hotchk155/QuadVCA/docs/header pins.docx

CONTROL BOARD

SNK3 | SRC2 (7SEG) | SNK1 | SNK4 | SNK6 | SRC4 (LEDS) | MIDI_IN_T Pin 4
SRC3 (7SEG) | SNK2 | SRC1 (7SEG) | SNK5 | SNK8 | SNK7 | MIDI_IN_R Pin 5

SW_READ Read line for multiplexed switches needs pull up | IND4 Channel D VCA status LED active low | CVIN3 Socket normalled to ground | CVIN2 Socket normalled to ground | SWITCH Active low needs pull up | CKIN Socket normalled to ground | DGND
DGND | CVIN4 Socket normalled to ground | IND3 Channel C VCA status LED active low | IND2 Channel B VCA status LED active low | IND1 Channel A VCA status LED active low | CVIN1 Socket normalled to ground | +5V

SIG_IN3 Channel C input socket tip Normalled to channel B input tip | SIG_OUT4 Channel D output tip | SIG_IN2 Channel B input socket tip Normalled to channel A input tip | AGND | ATT_IN4 C/W (top) end of track of attenuator pot D
SIG_IN4 Channel D input socket tip. Normalled to channel C input tip | SIG_OUT3 Channel C output tip | ATT_OUT2 Wiper of attenuator pot B | ATT_IN2 C/W (top) end of track of attenuator pot B | ATT_OUT4 Wiper of attenuator pot D

ATT_OUT1 Wiper of attenuator pot A | SIG_OUT1 Channel A output tip | SIG_OUT2 Channel B output tip | ATT_IN3 C/W (top) end of track of attenuator pot C | ATT_OUT3 Wiper of attenuator pot C
ATT_IN1 C/W (top) end of track of attenuator pot A | SIG_IN1 Channel A input socket tip. | AGND | AGND | AGND

BASE BOARD

SINK Shift reg pin via resistor | SRC transistor | SINK Shift reg pin via resistor | SINK Shift reg pin via resistor | SINK Shift reg pin via resistor | SRC transistor | MIDI Pin 4
SRC transistor | SINK Shift reg pin via resistor | SRC transistor | SINK Shift reg pin via resistor | SINK Shift reg pin via resistor | SINK Shift reg pin via resistor | MIDI Pin 5

KB_READ | IND4 To op-amp sink | CV Analog input | CV Analog input | SWITCH Input line | CKIN Analog input | DGND
DGND | CV Analog input | IND3 To op-amp sink | IND2 To op-amp sink | IND1 To op-amp sink | CV Analog input | +5V

Check indicator PWM vs VCA PWM vs sockets

A D

B C

SIGIN3 To VCA input C | SIGOUT4 | SIGIN2 | AGND | TO_ATT4
SIGIN4 | SIGOUT3 | FR_ATT2 | TO_ATT2 | FR_ATT4

FR_ATT1 | SIGOUT1 | SIGOUT2 | TO_ATT3 | FR_ATT3
TO_ATT1 | SIGIN1 | +12V | AGND | -12V
