hotchk155/QuadVCA/main_board/main_board.brd

## EAGLE design main_board/main_board.brd (2017-09-06)

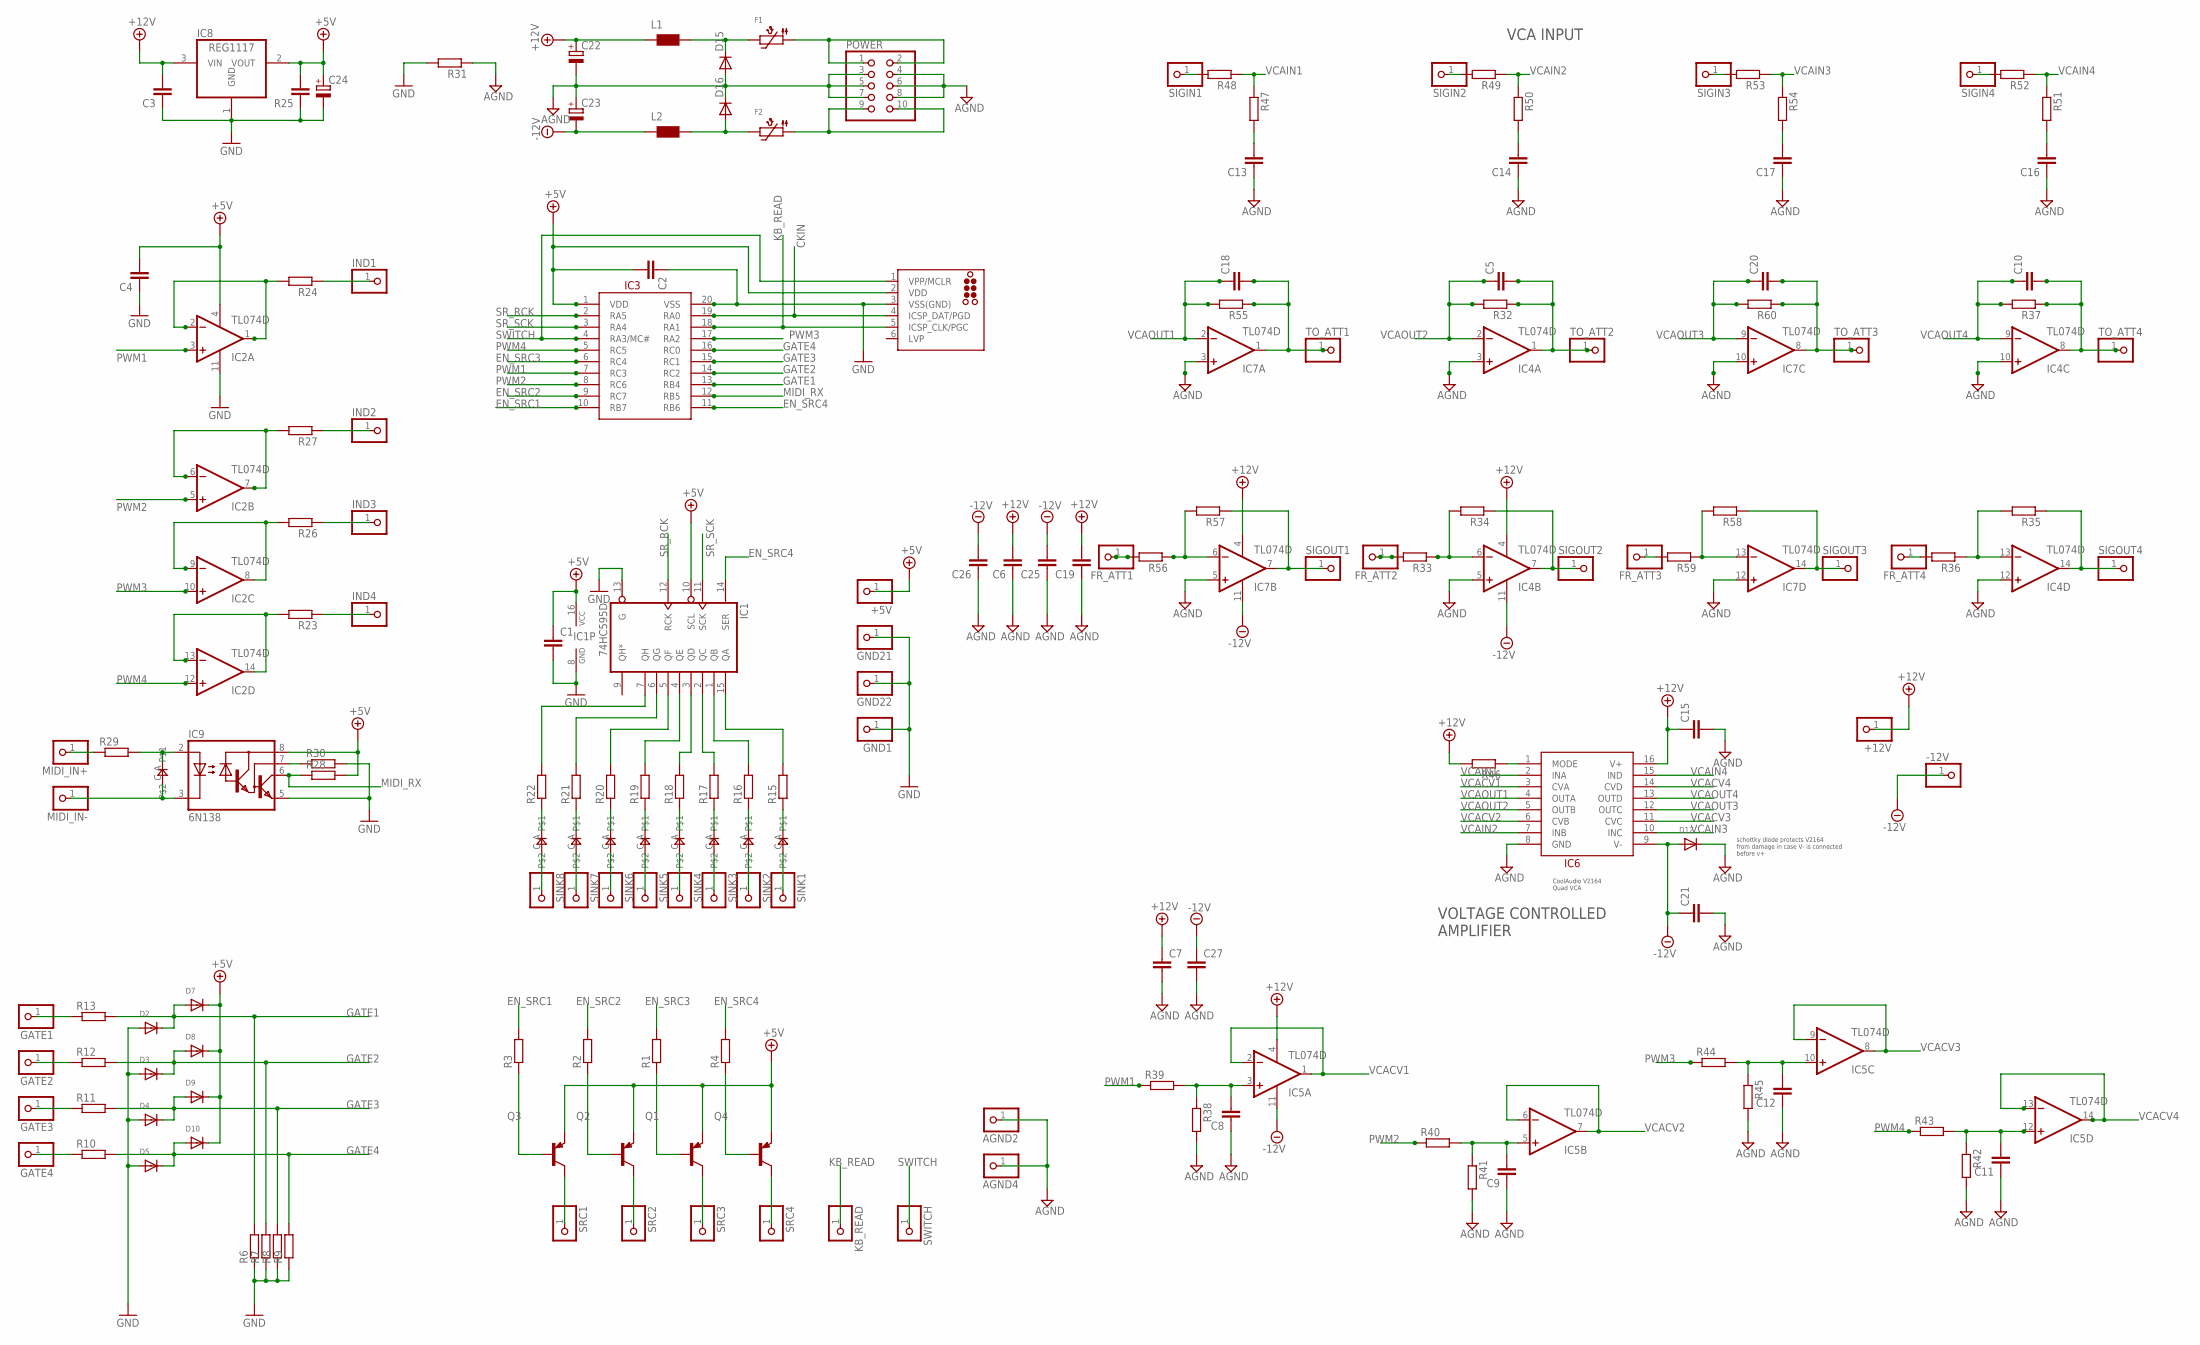
[picture p1: schematic main_board.sch]

Parts:
+5V, +12V: PINHD-1X1; 1X01
-12V: PINHD-1X1; 1X01
AGND2, AGND4: PINHD-1X1; 1X01
C1, C2, C3, C4, C5, C6, C7, C8, C9, C10, C11, C12, C13, C14, C15, C16, C17, C18, C19, C20, C21, C25, C26, C27: C-EUC0805; C0805
C22, C23: CPOL-EUE2.5-7; E2,5-7
C24: CPOL-EUE2.5-5; E2,5-5
D2, D3, D4, D5, D7, D8, D9, D10, D12: DIODESOD-123; SOD-123
D11, D13, D14, D17, D18, D19, D20, D21, D22: 0805DIODE
D15, D16: MBR0520LT; SOD123
F1, F2: PTC1210
FR_ATT1, FR_ATT2, FR_ATT3, FR_ATT4: PINHD-1X1; 1X01
GATE1, GATE2, GATE3, GATE4: PINHD-1X1; 1X01
GND1, GND21, GND22: PINHD-1X1; 1X01
IC1: 74HC595D; SO16
IC2, IC4, IC5, IC7: TL074D; SO14
IC3: PIC16F1829SOIC; SO20W
IC6: V2164; SO16
IC8: REG1117; SOT223
IC9: 6N138; DIL08
ICSP: TC2030-MCP-NL
IND1, IND2, IND3, IND4: PINHD-1X1; 1X01
KB_READ: PINHD-1X1; 1X01
L1, L2: WE-CBF_0805; 0805
MIDI_IN+: PINHD-1X1; 1X01
MIDI_IN-: PINHD-1X1; 1X01
POWER: PINHD-2X5; 2X05
Q1, Q2, Q3, Q4: MMBT3906LT1-PNP-SOT23-BEC; SOT23-BEC
R1, R2, R3, R4, R6, R7, R8, R9, R10, R11, R12, R13, R15, R16, R17, R18, R19, R20, R21, R22, R23, R24, R26, R27, R28, R29, R30, R31, R32, R33, R34, R35, R36, R37, R38, R39, R40, R41, R42, R43, R44, R45, R46, R47, R48, R49, R50, R51, R52, R53, R54, R55, R56, R57, R58, R59, R60: R-EU_R0805; R0805
R25: C-EUC0805; C0805
SIGIN1, SIGIN2, SIGIN3, SIGIN4: PINHD-1X1; 1X01
SIGOUT1, SIGOUT2, SIGOUT3, SIGOUT4: PINHD-1X1; 1X01
SINK1, SINK2, SINK3, SINK4, SINK5, SINK6, SINK7, SINK8: PINHD-1X1; 1X01
SRC1, SRC2, SRC3, SRC4: PINHD-1X1; 1X01
SWITCH: PINHD-1X1; 1X01
TO_ATT1, TO_ATT2, TO_ATT3, TO_ATT4: PINHD-1X1; 1X01

Connections:
+5V: +5V.1, C1.1, C2.2, C4.2, C24.+, D7.C, D8.C, D9.C, D10.C, IC1.10 (SCL), IC1.16 (VCC), IC2.4 (V+), IC3.1 (VDD), IC8.2 (VOUT), IC9.8 (VCC), ICSP.2 (VDD), Q1.E, Q2.E, Q3.E, Q4.E, R25.2, R28.2
+12V: +12V.1, C3.2, C6.2, C7.1, C15.1, C19.2, C22.+, IC4.4 (V+), IC5.4 (V+), IC6.16 (V+), IC7.4 (V+), IC8.3 (VIN), L1.1, R46.2
-12V: -12V.1, C21.1, C23.-, C25.2, C26.2, C27.1, D12.A, IC4.11 (V-), IC5.11 (V-), IC6.9 (V-), IC7.11 (V-), L2.1
AGND: AGND2.1, AGND4.1, C6.1, C7.2, C8.1, C9.1, C11.1, C12.1, C13.1, C14.1, C15.2, C16.1, C17.1, C19.1, C21.2, C22.-, C23.+, C25.1, C26.1, C27.2, D12.C, D15.A, D16.C, IC4.3 (+IN), IC4.5 (+IN), IC4.10 (+IN), IC4.12 (+IN), IC6.8 (GND), IC7.3 (+IN), IC7.5 (+IN), IC7.10 (+IN), IC7.12 (+IN), POWER.3, POWER.4, POWER.5, POWER.6, POWER.7, POWER.8, R31.1, R38.2, R41.2, R42.2, R45.2
CKIN: IC3.19 (RA0), ICSP.4 (ICSP_DAT/PGD)
EN_SRC1: IC3.10 (RB7), R3.2
EN_SRC2: IC3.9 (RC7), R2.2
EN_SRC3: IC3.6 (RC4), R1.2
EN_SRC4: IC1.14 (SER), IC3.11 (RB6), R4.2
FR_ATT1: FR_ATT1.1, R56.2
GATE1: D2.C, D7.A, IC3.13 (RB4), R6.2, R13.2
GATE2: D3.C, D8.A, IC3.14 (RC2), R7.2, R12.2
GATE3: D4.C, D9.A, IC3.15 (RC1), R8.2, R11.2
GATE4: D5.C, D10.A, IC3.16 (RC0), R9.2, R10.2
GND: C1.2, C2.1, C3.1, C4.1, C24.-, D2.A, D3.A, D4.A, D5.A, GND1.1, GND21.1, GND22.1, IC1.8 (GND), IC1.13 (G), IC2.11 (V-), IC3.20 (VSS), IC8.1 (GND), IC9.5 (GND), ICSP.3 (VSS(GND)), R6.1, R7.1, R8.1, R9.1, R25.1, R30.2, R31.2
KB_READ: IC3.18 (RA1), ICSP.5 (ICSP_CLK/PGC), KB_READ.1
MIDI_RX: IC3.12 (RB5), IC9.6 (VO), R28.1
unnamed: IC1.7 (QH), R22.2
unnamed: IC1.6 (QG), R21.2
unnamed: IC1.5 (QF), R20.2
unnamed: IC1.4 (QE), R19.2
unnamed: IC1.3 (QD), R18.2
unnamed: IC1.2 (QC), R17.2
unnamed: IC1.1 (QB), R16.2
unnamed: IC1.15 (QA), R15.2
unnamed: D13.A, R22.1
unnamed: D14.A, R21.1
unnamed: D17.A, R20.1
unnamed: D18.A, R19.1
unnamed: D19.A, R18.1
unnamed: D20.A, R17.1
unnamed: D21.A, R16.1
unnamed: D22.A, R15.1
unnamed: Q3.C, SRC1.1
unnamed: Q2.C, SRC2.1
unnamed: Q1.C, SRC3.1
unnamed: Q4.C, SRC4.1
unnamed: IC6.1 (MODE), R46.1
unnamed: Q3.B, R3.1
unnamed: Q2.B, R2.1
unnamed: Q1.B, R1.1
unnamed: Q4.B, R4.1
unnamed: D13.C, SINK8.1
unnamed: IC7.6 (-IN), R56.1, R57.2
unnamed: IC7.7 (OUT), R57.1, SIGOUT1.1
unnamed: D14.C, SINK7.1
unnamed: IC7.13 (-IN), R58.2, R59.1
unnamed: IC7.14 (OUT), R58.1, SIGOUT3.1
unnamed: D15.C, F1.P$2 (2), L1.2
unnamed: IC4.6 (-IN), R33.1, R34.2
unnamed: IC4.7 (OUT), R34.1, SIGOUT2.1
unnamed: D16.A, F2.P$2 (2), L2.2
unnamed: IC4.13 (-IN), R35.2, R36.1
unnamed: IC4.14 (OUT), R35.1, SIGOUT4.1
unnamed: C13.2, R47.2
unnamed: R48.2, SIGIN1.1
unnamed: C14.2, R50.2
unnamed: R49.2, SIGIN2.1
unnamed: C17.2, R54.2
unnamed: R53.2, SIGIN3.1
unnamed: C16.2, R51.2
unnamed: R52.2, SIGIN4.1
unnamed: IND1.1, R24.1
unnamed: IC2.1 (OUT), IC2.2 (-IN), R24.2
unnamed: C8.2, IC5.3 (+IN), R38.1, R39.2
unnamed: D17.C, SINK6.1
unnamed: IC2.6 (-IN), IC2.7 (OUT), R27.2
unnamed: IND2.1, R27.1
unnamed: C9.2, IC5.5 (+IN), R40.2, R41.1
unnamed: IC2.8 (OUT), IC2.9 (-IN), R26.2
unnamed: IND3.1, R26.1
unnamed: C12.2, IC5.10 (+IN), R44.2, R45.1
unnamed: IC2.13 (-IN), IC2.14 (OUT), R23.2
unnamed: IND4.1, R23.1
unnamed: C11.2, IC5.12 (+IN), R42.1, R43.2
unnamed: D18.C, SINK5.1
unnamed: FR_ATT2.1, R33.2
unnamed: GATE1.1, R13.1
unnamed: IC9.7 (VB), R30.1
unnamed: F2.P$1 (1), POWER.9, POWER.10
unnamed: D11.A, IC9.2 (A), R29.2
unnamed: D11.C, IC9.3 (C), MIDI_IN-.1
unnamed: MIDI_IN+.1, R29.1
unnamed: GATE2.1, R12.1
unnamed: GATE3.1, R11.1
unnamed: GATE4.1, R10.1
unnamed: FR_ATT3.1, R59.2
unnamed: FR_ATT4.1, R36.2
unnamed: D19.C, SINK4.1
unnamed: D20.C, SINK3.1
unnamed: F1.P$1 (1), POWER.1, POWER.2
unnamed: D21.C, SINK2.1
unnamed: D22.C, SINK1.1
PWM1: IC2.3 (+IN), IC3.7 (RC3), R39.1
PWM2: IC2.5 (+IN), IC3.8 (RC6), R40.1
PWM3: IC2.10 (+IN), IC3.17 (RA2), R44.1
PWM4: IC2.12 (+IN), IC3.5 (RC5), R43.1
SR_RCK: IC1.12 (RCK), IC3.2 (RA5)
SR_SCK: IC1.11 (SCK), IC3.3 (RA4)
SWITCH: IC3.4 (RA3/MC#), ICSP.1 (VPP/MCLR), SWITCH.1
TO_ATT1: C18.2, IC7.1 (OUT), R55.1, TO_ATT1.1
TO_ATT2: C5.2, IC4.1 (OUT), R32.1, TO_ATT2.1
TO_ATT3: C20.2, IC7.8 (OUT), R60.1, TO_ATT3.1
TO_ATT4: C10.2, IC4.8 (OUT), R37.1, TO_ATT4.1
VCACV1: IC5.1 (OUT), IC5.2 (-IN), IC6.3 (CVA)
VCACV2: IC5.6 (-IN), IC5.7 (OUT), IC6.6 (CVB)
VCACV3: IC5.8 (OUT), IC5.9 (-IN), IC6.11 (CVC)
VCACV4: IC5.13 (-IN), IC5.14 (OUT), IC6.14 (CVD)
VCAIN1: IC6.2 (INA), R47.1, R48.1
VCAIN2: IC6.7 (INB), R49.1, R50.1
VCAIN3: IC6.10 (INC), R53.1, R54.1
VCAIN4: IC6.15 (IND), R51.1, R52.1
VCAOUT1: C18.1, IC6.4 (OUTA), IC7.2 (-IN), R55.2
VCAOUT2: C5.1, IC4.2 (-IN), IC6.5 (OUTB), R32.2
VCAOUT3: C20.1, IC6.12 (OUTC), IC7.9 (-IN), R60.2
VCAOUT4: C10.1, IC4.9 (-IN), IC6.13 (OUTD), R37.2

Notes on the sheet:
schottky diode protects V2164 from damage in case V- is connected before v+
CoolAudio V2164 Quad VCA
VCA INPUT
VOLTAGE CONTROLLED AMPLIFIER

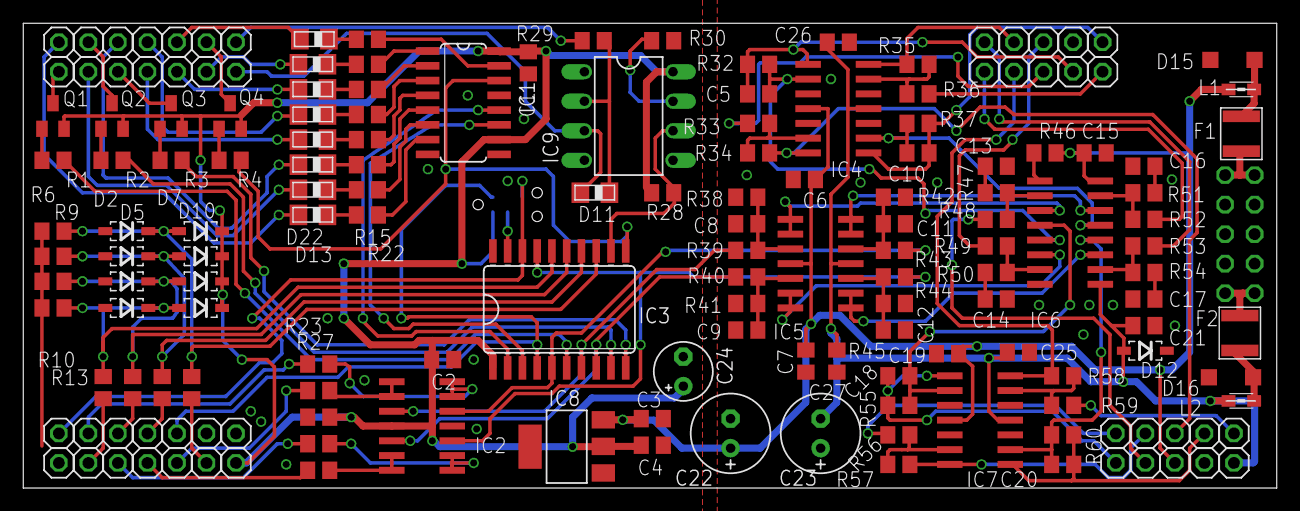
[picture p2: board main_board.brd from above]

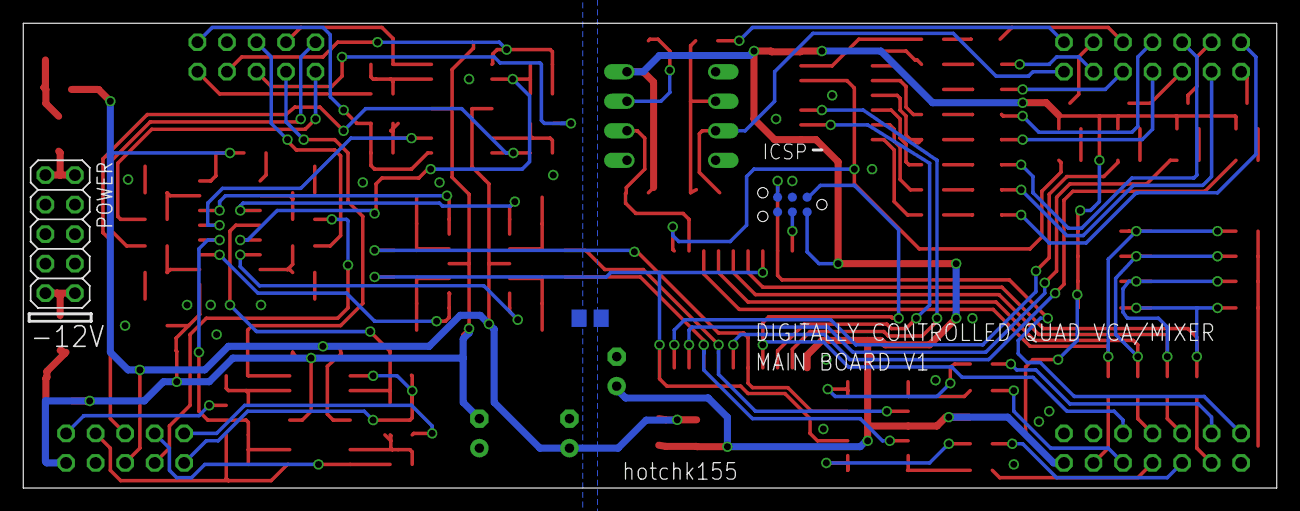
[picture p3: board main_board.brd from below]

Board: 2 copper layers, 107.8 x 40.0 mm, 172 parts (3 on the bottom side), 116 nets.
