hotchk155/QuadVCA/control_board/control_board.brd

## EAGLE design control_board/control_board.brd (2017-09-06)

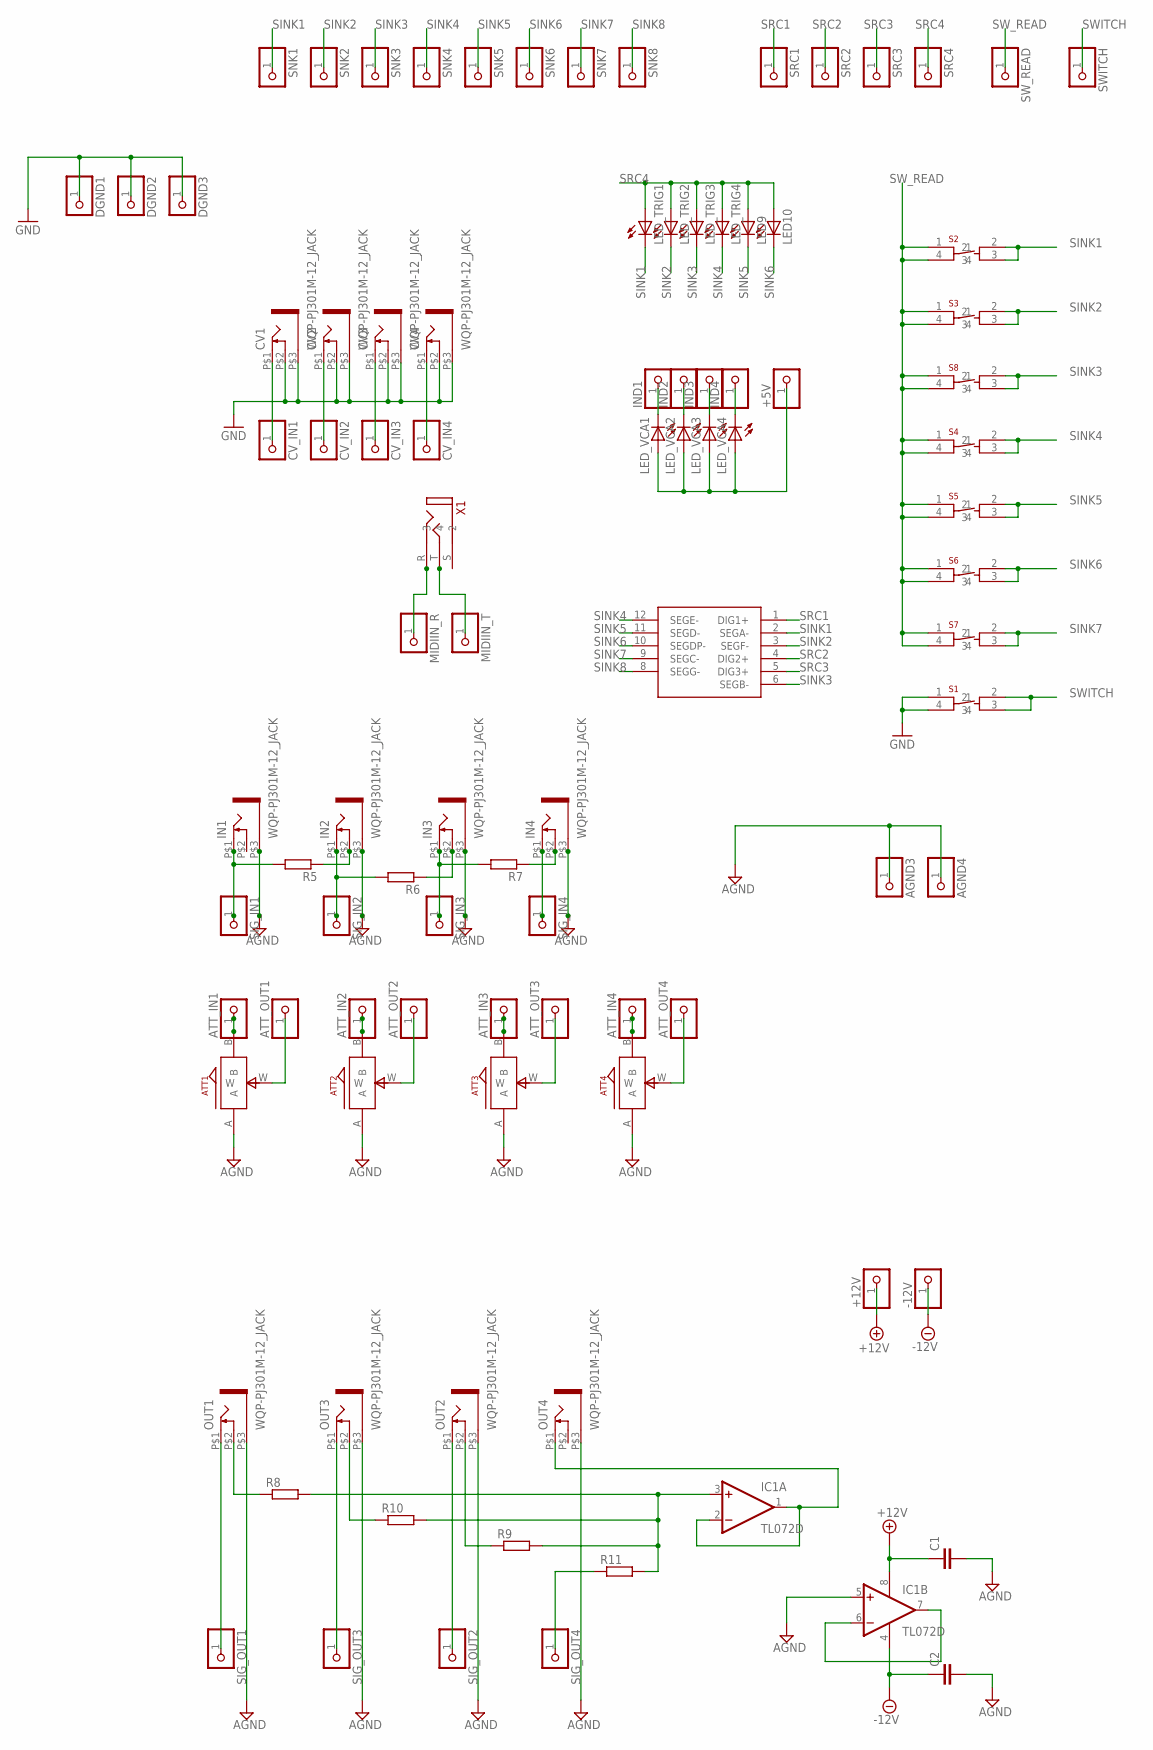
[picture p4: schematic control_board.sch]

Parts:
+5V, +12V: PINHD-1X1; 1X01
-12V: PINHD-1X1; 1X01
AGND3, AGND4: PINHD-1X1; 1X01
ATT1, ATT2, ATT3, ATT4: ALPS_POT_SMALL; SMALL_ALPS_POT
ATT_IN1, ATT_IN2, ATT_IN3, ATT_IN4: PINHD-1X1; 1X01
ATT_OUT1, ATT_OUT2, ATT_OUT3, ATT_OUT4: PINHD-1X1; 1X01
C1, C2: C-EUC0805; C0805
CV1, CV2, CV3, CV4: WQP-PJ301M-12_JACK
CV_IN1, CV_IN2, CV_IN3, CV_IN4: PINHD-1X1; 1X01
DGND1, DGND2, DGND3: PINHD-1X1; 1X01
DISP1: KYX2381_TRIPLE7SEG
IC1: TL072D; SO08
IN1, IN2, IN3, IN4: WQP-PJ301M-12_JACK
IND1, IND2, IND3, IND4: PINHD-1X1; 1X01
LED9, LED10: LED3MM
LED_TRIG1, LED_TRIG2, LED_TRIG3, LED_TRIG4: LED3MM
LED_VCA1, LED_VCA2, LED_VCA3, LED_VCA4: LED3MM
MIDIIN_R: PINHD-1X1; 1X01
MIDIIN_T: PINHD-1X1; 1X01
OUT1, OUT2, OUT3, OUT4: WQP-PJ301M-12_JACK
R5, R6, R7, R8, R9, R10, R11: R-EU_R0805; R0805
S1, S2, S3, S4, S5, S6, S7, S8: 6MM_TACT; 6MMTACT
SIG_IN1, SIG_IN2, SIG_IN3, SIG_IN4: PINHD-1X1; 1X01
SIG_OUT1, SIG_OUT2, SIG_OUT3, SIG_OUT4: PINHD-1X1; 1X01
SNK1, SNK2, SNK3, SNK4, SNK5, SNK6, SNK7, SNK8: PINHD-1X1; 1X01
SRC1, SRC2, SRC3, SRC4: PINHD-1X1; 1X01
SWITCH: PINHD-1X1; 1X01
SW_READ: PINHD-1X1; 1X01
X1: VERTICAL_3_5MM_SOCKETTHONK; PJ301CM

Connections:
+5V: +5V.1, LED_VCA1.A, LED_VCA2.A, LED_VCA3.A, LED_VCA4.A
+12V: +12V.1, C1.1, IC1.8 (V+)
-12V: -12V.1, C2.1, IC1.4 (V-)
AGND: AGND3.1, AGND4.1, ATT1.A, ATT2.A, ATT3.A, ATT4.A, C1.2, C2.2, IC1.5 (+IN), IN1.P$3 (1), IN2.P$3 (1), IN3.P$3 (1), IN4.P$3 (1), OUT1.P$3 (1), OUT2.P$3 (1), OUT3.P$3 (1), OUT4.P$3 (1)
GND: CV1.P$2 (3), CV1.P$3 (1), CV2.P$2 (3), CV2.P$3 (1), CV3.P$2 (3), CV3.P$3 (1), CV4.P$2 (3), CV4.P$3 (1), DGND1.1, DGND2.1, DGND3.1, S1.1, S1.4
unnamed: ATT1.W, ATT_OUT1.1
unnamed: ATT1.B, ATT_IN1.1
unnamed: ATT3.W, ATT_OUT3.1
unnamed: ATT2.B, ATT_IN2.1
unnamed: ATT2.W, ATT_OUT2.1
unnamed: ATT3.B, ATT_IN3.1
unnamed: ATT4.W, ATT_OUT4.1
unnamed: ATT4.B, ATT_IN4.1
unnamed: OUT1.P$2 (3), R8.1
unnamed: IN2.P$1 (2), R6.2, SIG_IN2.1
unnamed: IN3.P$1 (2), R7.2, SIG_IN3.1
unnamed: IN4.P$1 (2), SIG_IN4.1
unnamed: CV1.P$1 (2), CV_IN1.1
unnamed: CV2.P$1 (2), CV_IN2.1
unnamed: CV3.P$1 (2), CV_IN3.1
unnamed: CV4.P$1 (2), CV_IN4.1
unnamed: OUT1.P$1 (2), SIG_OUT1.1
unnamed: MIDIIN_R.1, X1.R (3)
unnamed: MIDIIN_T.1, X1.T (4)
unnamed: IND1.1, LED_VCA1.K (C)
unnamed: IND2.1, LED_VCA2.K (C)
unnamed: IND3.1, LED_VCA3.K (C)
unnamed: IND4.1, LED_VCA4.K (C)
unnamed: OUT3.P$1 (2), SIG_OUT3.1
unnamed: OUT2.P$1 (2), SIG_OUT2.1
unnamed: R11.1, SIG_OUT4.1
unnamed: IN2.P$2 (3), R5.1
unnamed: IN3.P$2 (3), R6.1
unnamed: IN4.P$2 (3), R7.1
unnamed: IN1.P$1 (2), R5.2, SIG_IN1.1
unnamed: OUT3.P$2 (3), R10.1
unnamed: OUT2.P$2 (3), R9.1
unnamed: IC1.3 (+IN), R8.2, R9.2, R10.2, R11.2
unnamed: IC1.1 (OUT), IC1.2 (-IN), OUT4.P$1 (2)
unnamed: IC1.6 (-IN), IC1.7 (OUT)
SINK1: DISP1.2 (SEGA-), LED_TRIG1.K (C), S2.2, S2.3, SNK1.1
SINK2: DISP1.3 (SEGF-), LED_TRIG2.K (C), S3.2, S3.3, SNK2.1
SINK3: DISP1.6 (SEGB-), LED_TRIG3.K (C), S8.2, S8.3, SNK3.1
SINK4: DISP1.12 (SEGE-), LED_TRIG4.K (C), S4.2, S4.3, SNK4.1
SINK5: DISP1.11 (SEGD-), LED9.K (C), S5.2, S5.3, SNK5.1
SINK6: DISP1.10 (SEGDP-), LED10.K (C), S6.2, S6.3, SNK6.1
SINK7: DISP1.9 (SEGC-), S7.2, S7.3, SNK7.1
SINK8: DISP1.8 (SEGG-), SNK8.1
SRC1: DISP1.1 (DIG1+), SRC1.1
SRC2: DISP1.4 (DIG2+), SRC2.1
SRC3: DISP1.5 (DIG3+), SRC3.1
SRC4: LED9.A, LED10.A, LED_TRIG1.A, LED_TRIG2.A, LED_TRIG3.A, LED_TRIG4.A, SRC4.1
SWITCH: S1.2, S1.3, SWITCH.1
SW_READ: S2.1, S2.4, S3.1, S3.4, S4.1, S4.4, S5.1, S5.4, S6.1, S6.4, S7.1, S7.4, S8.1, S8.4, SW_READ.1

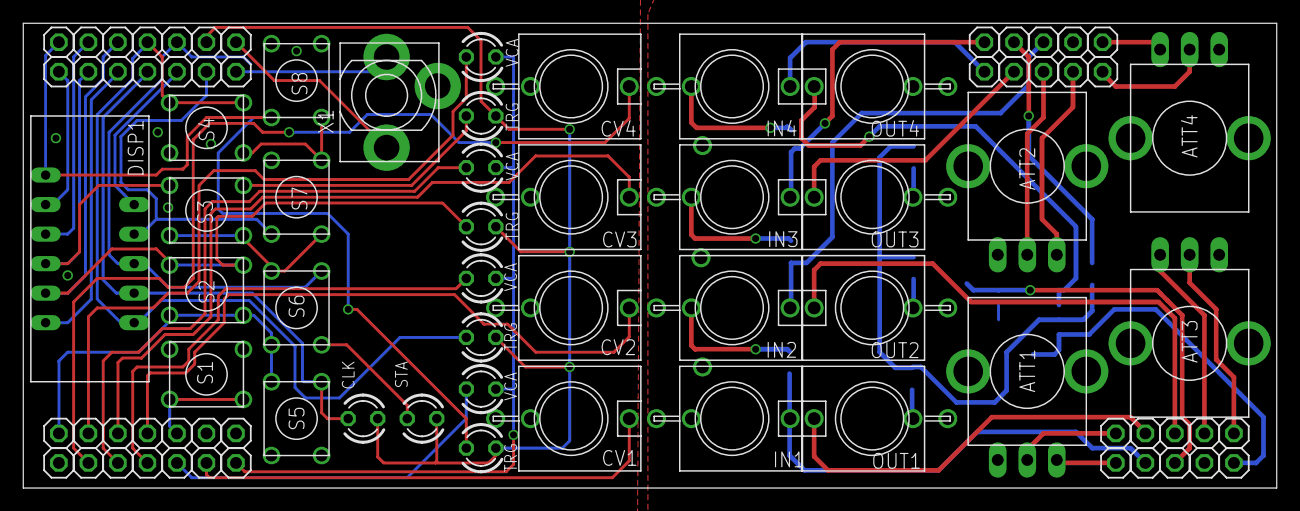
[picture p5: board control_board.brd from above]

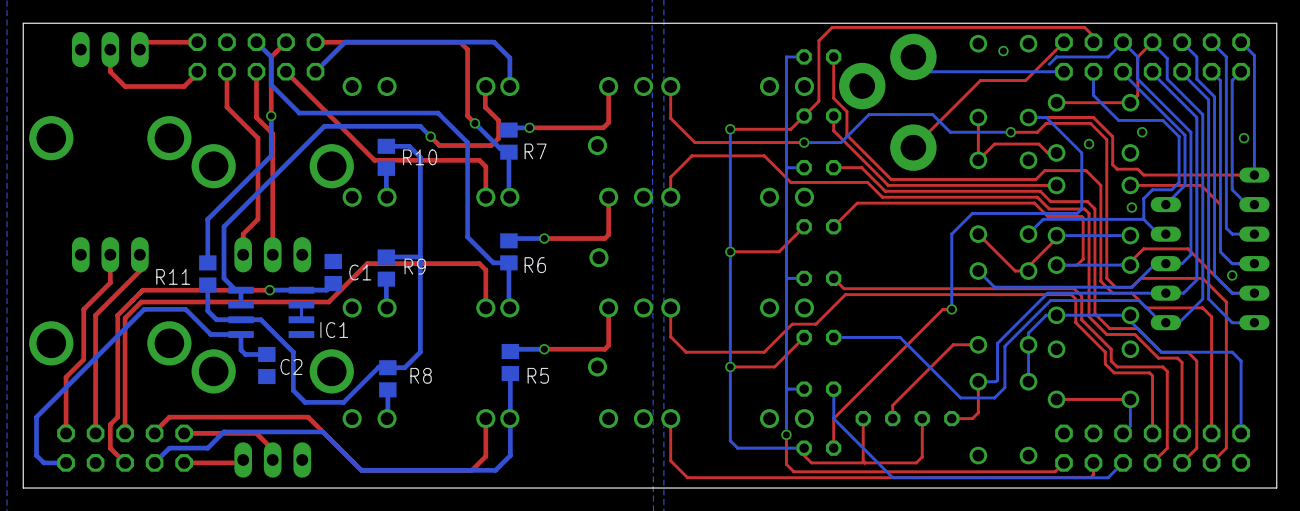
[picture p6: board control_board.brd from below]

Board: 2 copper layers, 107.8 x 40.0 mm, 94 parts (10 on the bottom side), 54 nets.
