hotchk155/QuadVCA/(commit log)

2017-07-09 in work
    [control_board.brd, control_board.sch, main_board.brd, main_board.sch]
2017-07-10 moar stuffs
    [control_board.brd, control_board.sch, main_board.brd]
2017-07-10 and more
    [control_board.brd, control_board.sch, main_board.brd, main_board.sch]
